maxkueffelbbraun/Space_Battery_SIM/Dok/PCB/BOM/Space_Battery_Test.xlsx

Designator | Name | Description | Quantity | SAP-Partnumber | Manufacturer 1 | Manufacturer Part Number 1 | Supplier Unit Price 1
B1 | ESP32-C6-Zero | ESP32-C6 Mini Development Board, Based on ESP32-C6FH4, Dual Processors, 160MHz Running Frequency, 2.4GHz WiFi 6 & Bluetooth 5, ESP32 Development Board | 1
C1, C2, C3 | 3.9nF | CAP 3.9nF 5% C0G 50V | 3 | 35031280
D1, D2 | 150060VS55040 | Led Green 0603 SMD | 2 | 35146000 | Wurth Elektronik | 150060VS55040 | 0.19
D3, D4 | LED 3mm red | LED Red, 625 nm, GaAsP/GaP, THT, 3mm | 2
D5 | CPDV3V3A-HF | Unidirectional ESD protection diode | 1 | 35140169
D6 (ISP) | BZX84-C20,215 | DIODE ZENER 20V 250MW SOT23 | 1 |  | Nexperia | BZX84-C20,215 | 0.0201
D7 (ISP) | BAV99W,135 | DIODE ARRAY GP 100V 150MA SOT323 | 1 |  | Nexperia | BAV99W,135 | 0.1544
J1, J2 | HDR_M_1X9 |  | 2
J3, J5, J6, J7, J8, J9, J10, J12, J13, J22 | 5-825433-0_2/50 | THT Pin Header, 1x2, 2.54mm, stehend | 10 | 33193339
J4, J11 | Header 1x5 | Header 1x5 2.54mm | 2
Q1 | SI7617DN-T1-GE3 | FET P-CH | 1 | 35140024 | Vishay | SI7617DN-T1-GE3 | 1.78
Q2 | 2N7002LT3G | N-Channel MOSFET 60V 115m, SMD SOT23-3 | 1 | 35140038 | onsemi | 2N7002LT3G | 0.35
Q3, Q4 | IRLMS2002 | FET N-Ch | 2 | 35140704
Q5 (ISP) | BCP51 | BCP51 Trans Gp Bjt PNP 45V 1.5A 1000MW 4-PIN(3+TAB) SOT-223 T/r / Trans PNP 45V 1.5A SOT-223 | 1 |  | onsemi | BCP51 | 0.106
Q6 (ISP) | BCX70G | NPN Silicon AF Transistor, 45 V VCEO, 100 mA IC, SOT23, Reel, Green | 1 |  | Infineon | BCX70GE6327HTSA1 | 0.39
R1, R2, R6 | 2k2 | RES 2K2 1% 125mW 0805 | 3 | 35110490 | Yageo Group | RC0805FR-132K2L | 0.01465
R3 | 36k | RES 2K2 1% 125mW 0805 | 1 | 35110490 | Yageo Group | RC0805FR-132K2L | 0.01465
R4, R7, R9, R12, R13, R14, R15, R16, R17 | 10k | RES 2K2 1% 125mW 0805 | 9 | 35110490 | Yageo Group | RC0805FR-132K2L | 0.01465
R5 | 20k | RES 2K2 1% 125mW 0805 | 1 | 35110490 | Yageo Group | RC0805FR-132K2L | 0.01465
R8 | 100 | RES 2K2 1% 125mW 0805 | 1 | 35110490 | Yageo Group | RC0805FR-132K2L | 0.01465
R10, R11 | 220 | RES 2K2 1% 125mW 0805 | 2 | 35110490 | Yageo Group | RC0805FR-132K2L | 0.01465
R18, R19 | 1k | RES 2K2 1% 125mW 0805 | 2 | 35110490 | Yageo Group | RC0805FR-132K2L | 0.01465
R20, R22, R23 | 5.6E | RES 2K2 1% 125mW 0805 | 3 | 35110490 | Yageo Group | RC0805FR-132K2L | 0.01465
R21 | 47k | RES 2K2 1% 125mW 0805 | 1 | 35110490 | Yageo Group | RC0805FR-132K2L | 0.01465
SW1 | WE_416131160803 | SMD DIP-Switch tripple 1.27mm pitch | 1 |  | Wurth Elektronik | 416131160803 | 3.41
U1 | TSR 1-2450 | DC/DC converter, 5 VDC, 1000 mA, -40 to 85 degC, 3-Pin SIP, RoHS | 1 |  | Traco Power | TSR 1-2450 | 5.91
U2 | NSB1706DMW5T1G | Dual Bias Resistor Transistors, NPN Silicon Surface Mount Transistor, 5-Pin SC70, Pb-Free, Tape and Reel | 1 |  | onsemi | NSB1706DMW5T1G | 0.29
U3 | TS5A23157DGSR | IC SWITCH DUAL SPDT 10MSOP | 1 |  | Texas Instruments | TS5A23157DGSR
U4 | ISO6721BDR | General-purpose, dual-channel, 1/1 digital isolator 8-SOIC -40 to 125 | 1
