maxkueffelbbraun/Space_Battery_SIM/Dok/PCB/Space_Battery_Test V2/Altium/SSOP16_3P98X5_TEX.step

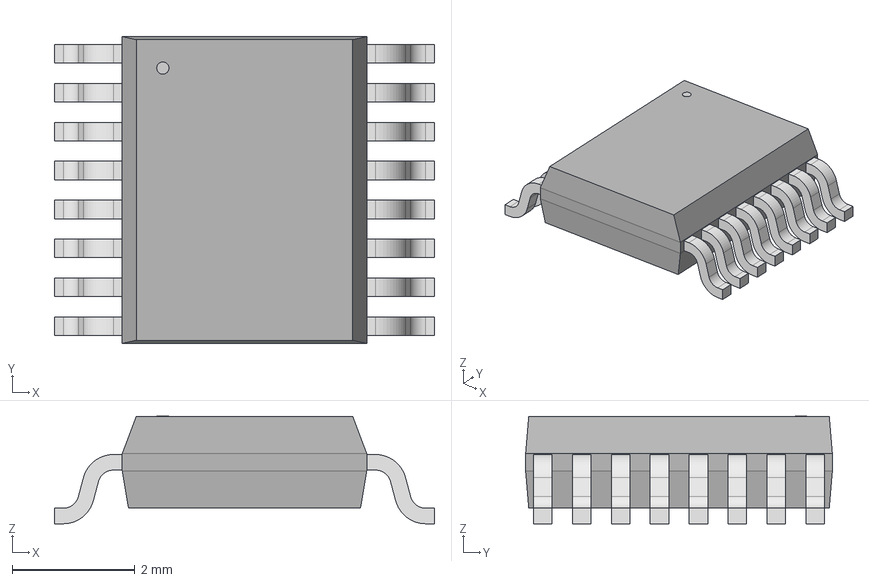
[picture p3: CAD file, 2026-10-27]
Dok/PCB/Space_Battery_Test V2/Altium/SSOP16_3P98X5_TEX.step
6.20 x 5.00 x 1.75 mm
