maxkueffelbbraun/Space_Battery_SIM/Dok/PCB/Space_Battery_Test V2/Altium/ul_ISO6721BDR/Altium/ISO6721BDR/SOIC_1BDR_TEX.step

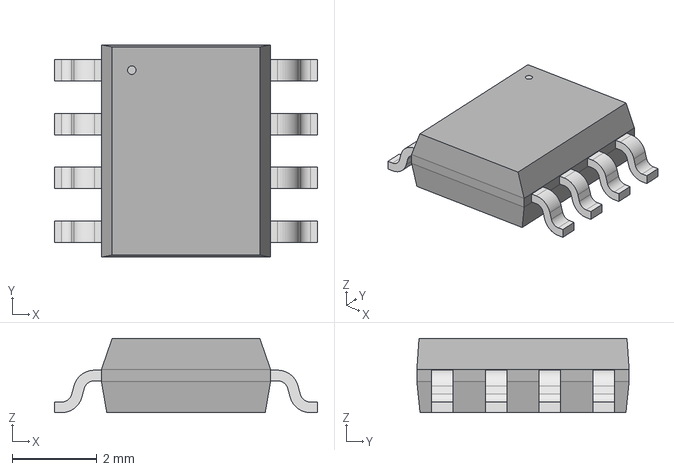
[picture p4: CAD file, 2026-10-27]
Dok/PCB/Space_Battery_Test V2/Altium/ul_ISO6721BDR/Altium/ISO6721BDR/SOIC_1BDR_TEX.step
6.20 x 5.00 x 1.75 mm
