maxkueffelbbraun/Space_Battery_SIM/Dok/PCB/Space_Battery_Test V2/Space_Battery_Test.html

Reporting Options

# File in Newer Format

Date | : | 14.10.2026
Time | : | 22:46:23
Filename | : | C:\Users\kuefmade\OneDrive - B. Braun\Projects\Space\BatteryPack\Simulator\PCB\Space_Battery_Test\Space_Battery_Test.PrjPcb

Version | Warning

Release 23.10

CAUTION - This project contains rules defined using the Constraint Manager. You are seeing this message for two possible reasons. Firstly, this is an older version of the software that does not support this feature, in which case design rules will fall back to being presented as standard, query-based rules. If you save the PCB project in this older version of Altium Designer, all Constraint Manager data structure information will be lost. Secondly, if this software version does support the feature, then you currently don't have the level of Altium Designer Software Subscription (Pro/Enterprise) to be able to edit constraints using the Constraint Manager, in which case it will present rules in view only mode.

This file was generated by a later version of the software
