maxkueffelbbraun/Space_Battery_SIM/Dok/08-Testing Tool/Update tool/Updatetool label.docx

B|BRAUN

Update Tool NiMH Charging Unit

Battery-Pack SP NiMH (8713180A/ 8713180)

Attention: This device shall only be operated

by authorized B.Braun service technicians.

Version.10-2024-V01

B.Braun Melsungen AG

34209 Melsungen, Germany
