maxkueffelbbraun/Space_Battery_SIM/Dok/08-Testing Tool/Update tool/I0027610000 V01 S15 Rev.A - NiMH Akku update tool.pdf

2

3

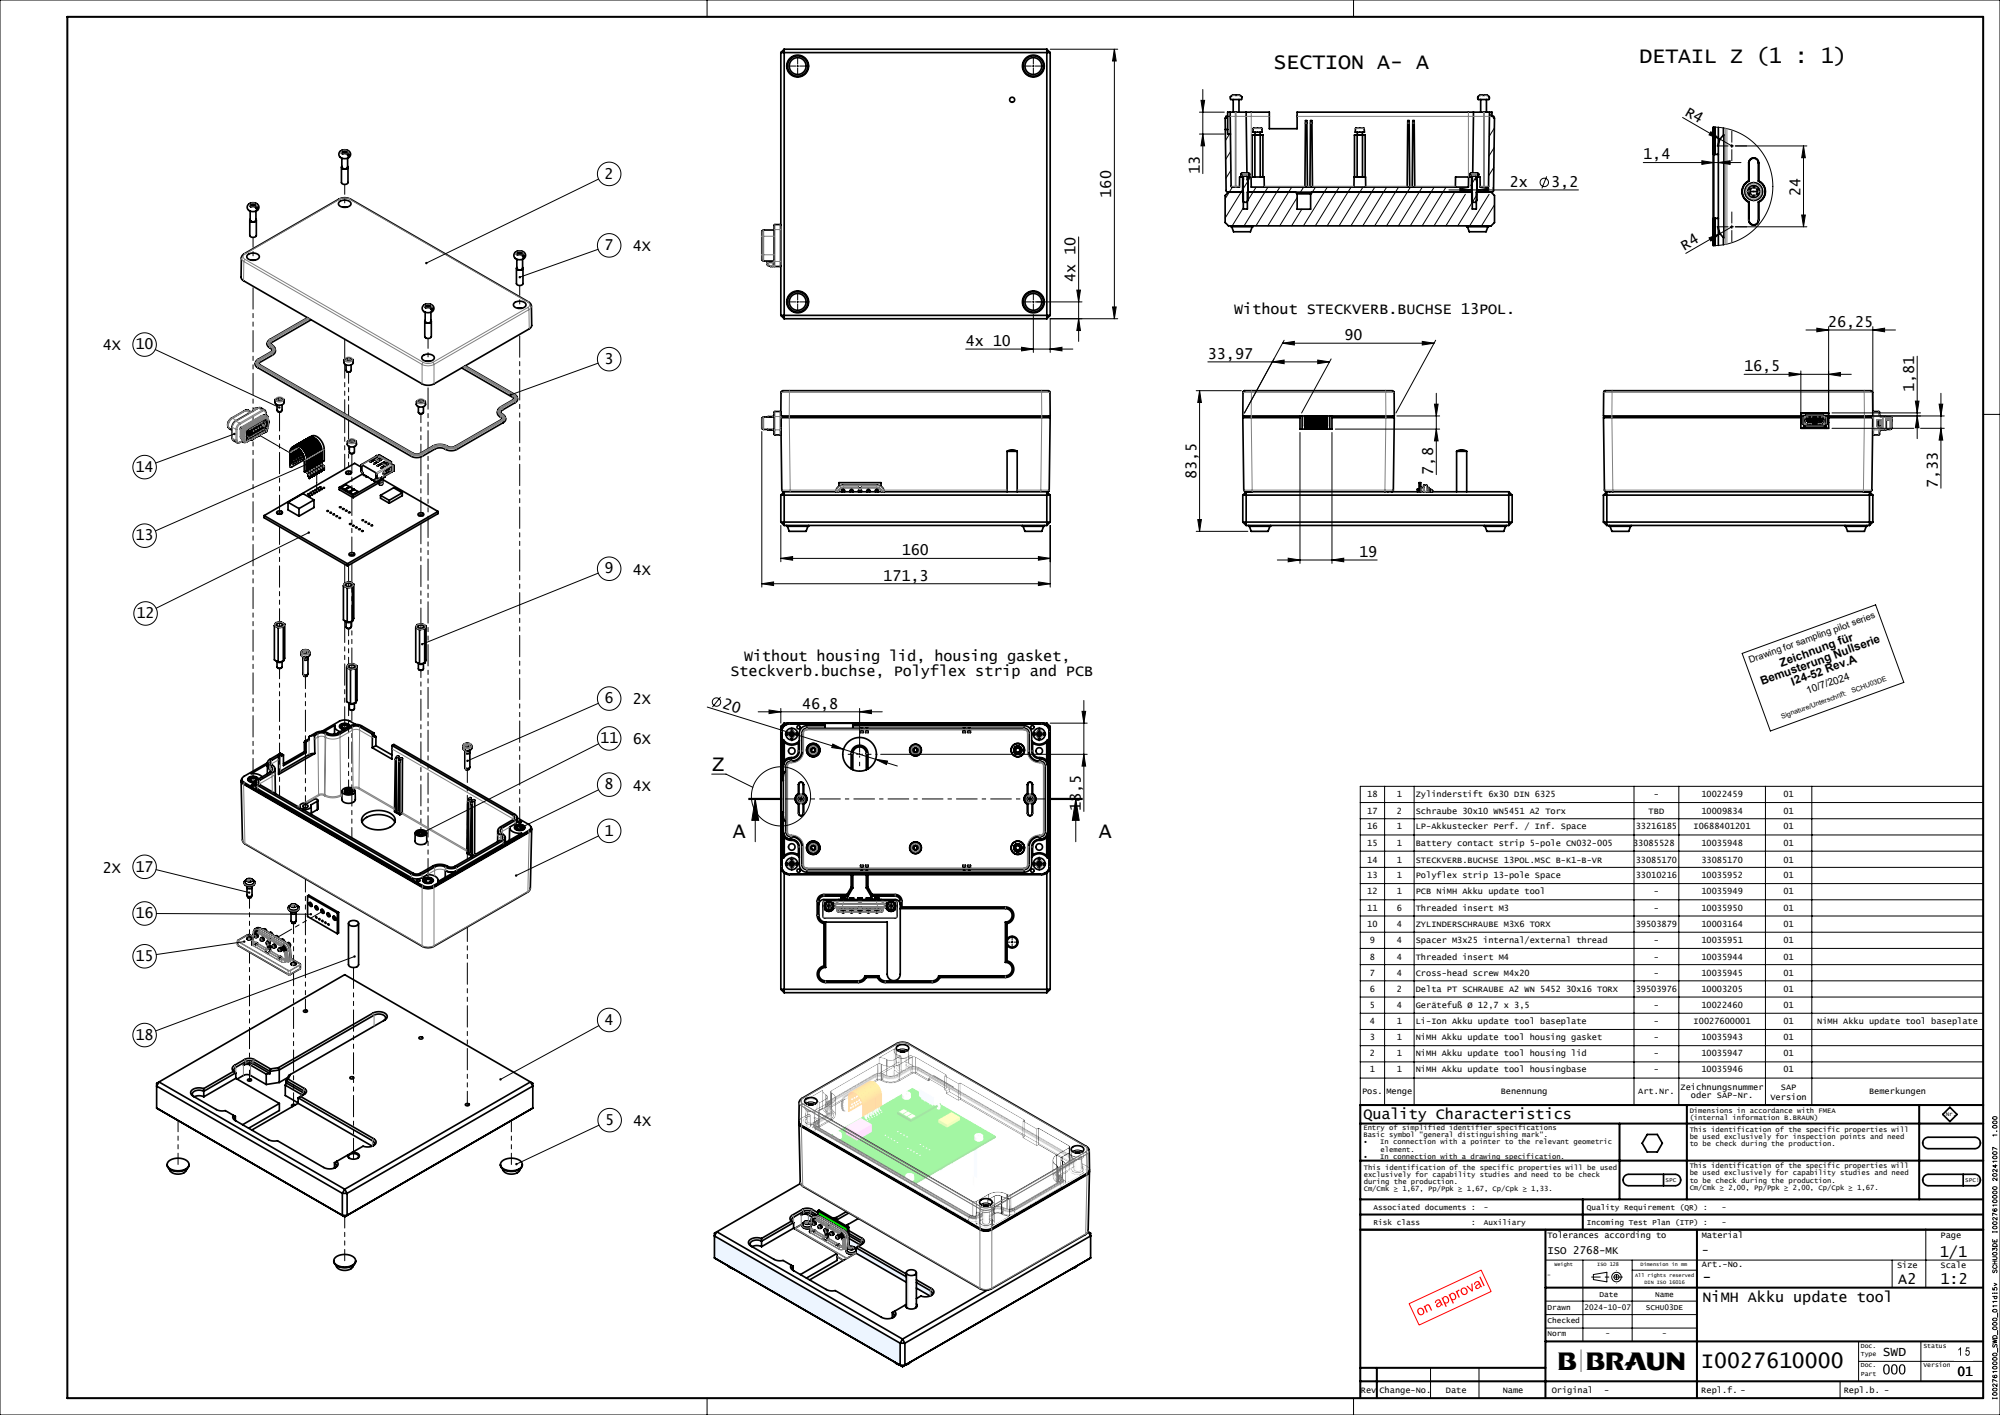
[picture p5: page 1]
10/7/2024 Signature/Unterschrift: SCHU03DE; DETAIL Z (1 : 1); SECTION A- A

Without STECKVERB.BUCHSE 13POL.

Drawing for sampling pilot series

Zeichnung für Bemusterung Nullserie I24-52 Rev.A

Without housing lid, housing gasket,
Steckverb.buchse, Polyflex strip and PCB

18 | 1 | Zylinderstift 6x30 DIN 6325 | - | 10022459 | 01

17 | 2 | Schraube 30x10 WN5451 A2 Torx | TBD | 10009834 | 01
16 | 1 | LP-Akkustecker Perf. / Inf. Space | 33216185 | I0688401201 | 01

15 | 1 | Battery contact strip 5-pole CN032-005 | 33085528 | 10035948 | 01

14 | 1 | STECKVERB.BUCHSE 13POL.MSC B-K1-B-VR | 33085170 | 33085170 | 01
13 | 1 | Polyflex strip 13-pole Space | 33010216 | 10035952 | 01

12 | 1 | PCB NiMH Akku update tool | - | 10035949 | 01

11 | 6 | Threaded insert M3 | - | 10035950 | 01

10 | 4 | ZYLINDERSCHRAUBE M3X6 TORX | 39503879 | 10003164 | 01
9 | 4 | Spacer M3x25 internal/external thread | - | 10035951 | 01

8 | 4 | Threaded insert M4 | - | 10035944 | 01

7 | 4 | Cross-head screw M4x20 | - | 10035945 | 01

6 | 2 | Delta PT SCHRAUBE A2 WN 5452 30x16 TORX | 39503976 | 10003205 | 01

5 | 4 | Gerätefuß Ø 12,7 x 3,5 | - | 10022460 | 01
4 | 1 | Li-Ion Akku update tool baseplate | - | I0027600001 | 01 | NiMH Akku update tool baseplate

3 | 1 | NiMH Akku update tool housing gasket | - | 10035943 | 01

2 | 1 | NiMH Akku update tool housing lid | - | 10035947 | 01

1 | 1 | NiMH Akku update tool housingbase | - | 10035946 | 01

Pos. | Menge | Benennung | Art.Nr. | Zeichnungsnummer oder SAP-Nr. | SAP Version | Bemerkungen

Dimensions in accordance with FMEA Quality Characteristics (internal information B.BRAUN) | Nr.

Entry of simplified identifier specifications Basic symbol "general distinguishing mark". • In connection with a pointer to the relevant geometric element. • In connection with a drawing specification. | | This identification of the specific properties will be used exclusively for inspection points and need to be check during the production.

This identification of the specific properties will be used exclusively for capability studies and need to be check during the production. Cm/Cmk ≥ 1,67, Pp/Ppk ≥ 1,67, Cp/Cpk ≥ 1,33. | SPC | This identification of the specific properties will be used exclusively for capability studies and need to be check during the production. Cm/Cmk ≥ 2,00, Pp/Ppk ≥ 2,00, Cp/Cpk ≥ 1,67. | SPC!

Associated documents : - | Quality Requirement (QR) : -

Risk class : Auxiliary | Incoming Test Plan (ITP) : -

Tolerances according to ISO 2768-MK Weight ISO 128 Dimension in mm | Material Page -1/1 Art.-No. Scale Size - 1:2 A2

All rights reserved
DIN ISO 16016

Date Name Drawn 2024-10-07 SCHU03DE Checked Norm -- | NiMH Akku update tool

B|BRAUN | I0027610000 | Doc. SWD Type 000 Part | Status Version 01 Doc. 01

Rev | Change-No. Date Name | Original - | Repl.f. - -Repl.b.
