maxkueffelbbraun/Space_Battery_SIM/Dok/Schematic.pdf

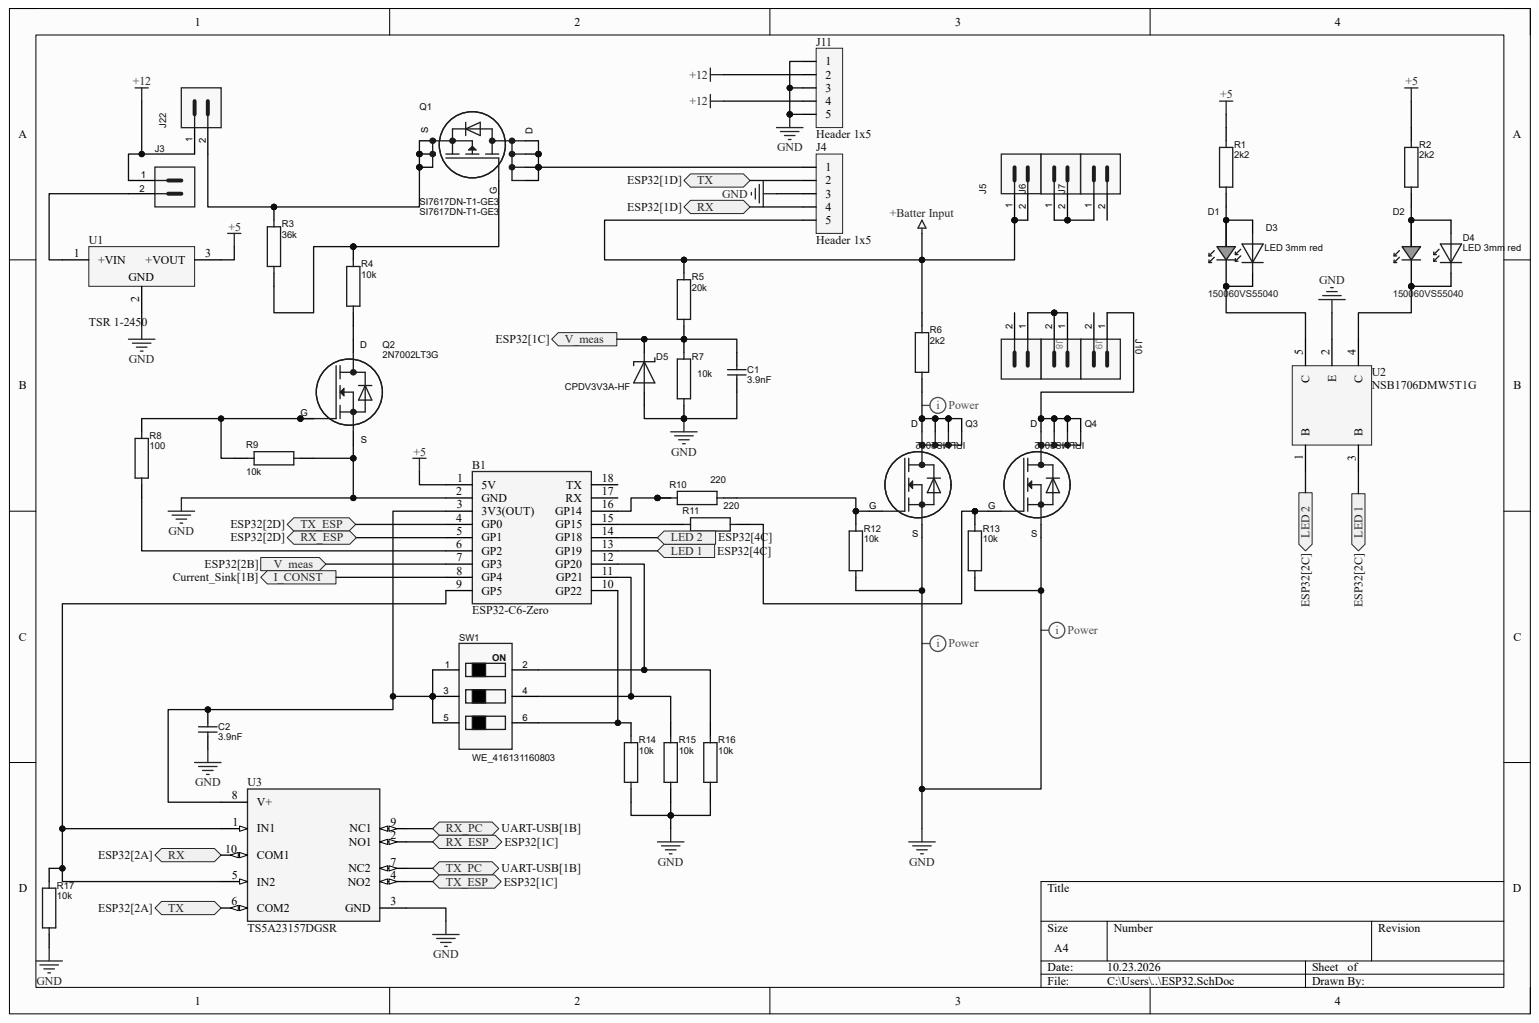
[picture p6: page 1]

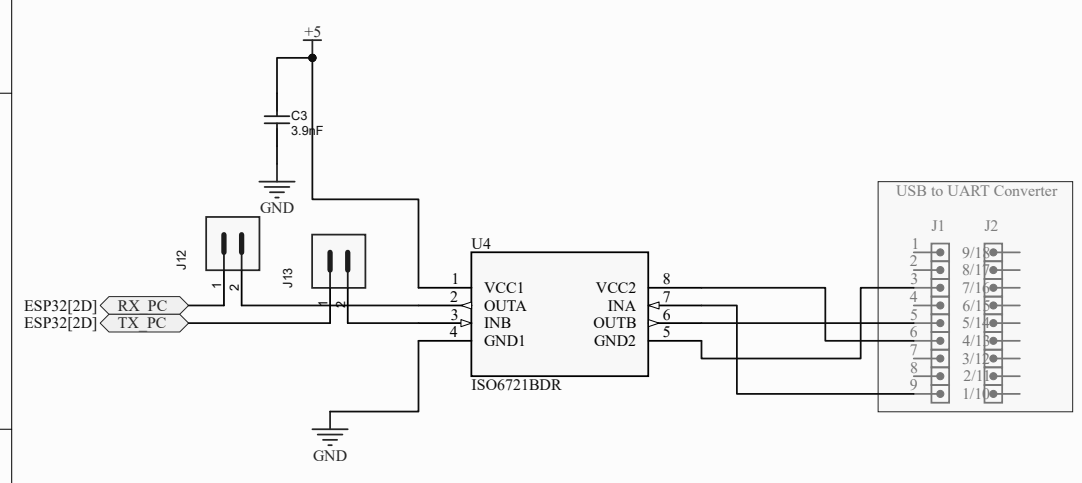
[picture p7: page 2]
Title; Size; Number; Revision; File:; C:\Users\..\UART-USB.SchDoc; Drawn By:; ESP32[2D] RX_PC ESP32[2D] TX_PC; GND; VCC1 1 OUTA 2 INB 3; GND1 4; GND2; OUTB; INA; VCC2; ISO6721BDR ¹

USB to UART Converter

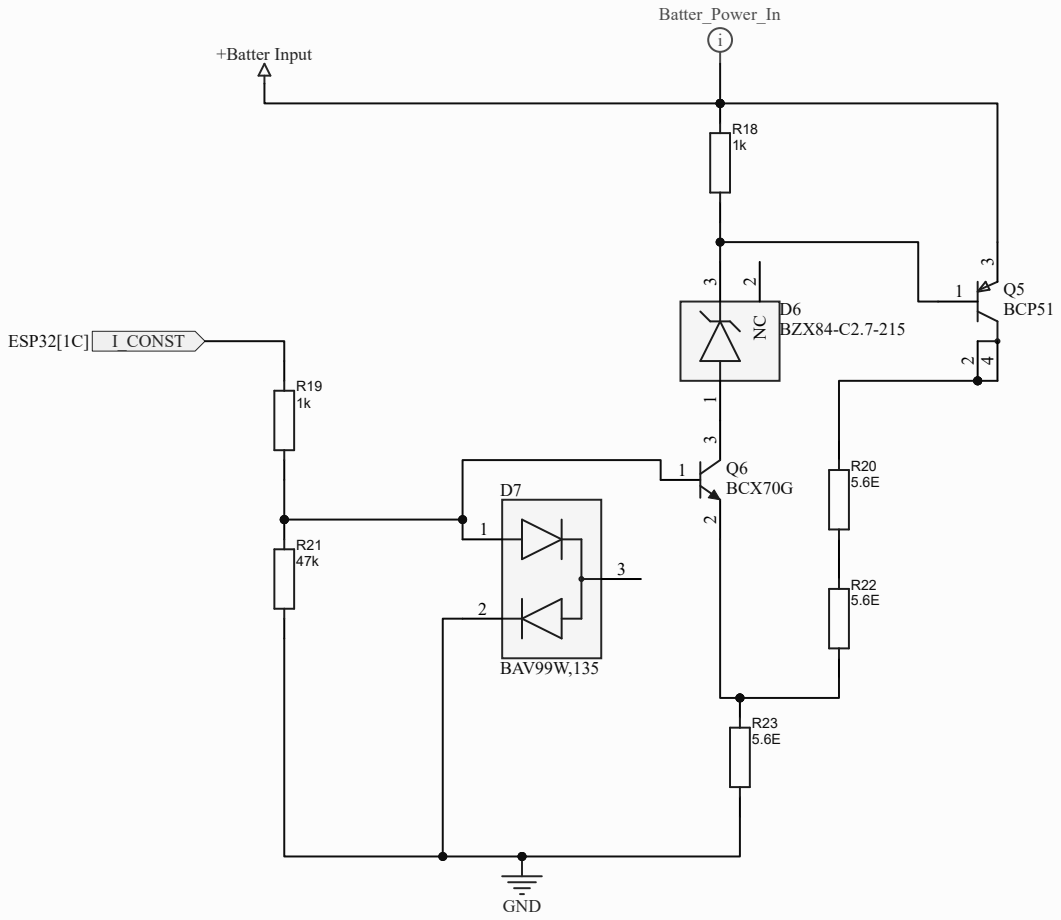
[picture p8: page 3]
