maxkueffelbbraun/Space_Battery_SIM/Dok/PCB/Space_Battery_Test V2/Fertigungsdaten/Zeichnungen/Space - Battery_Test - Bestückzeichnung.PDF

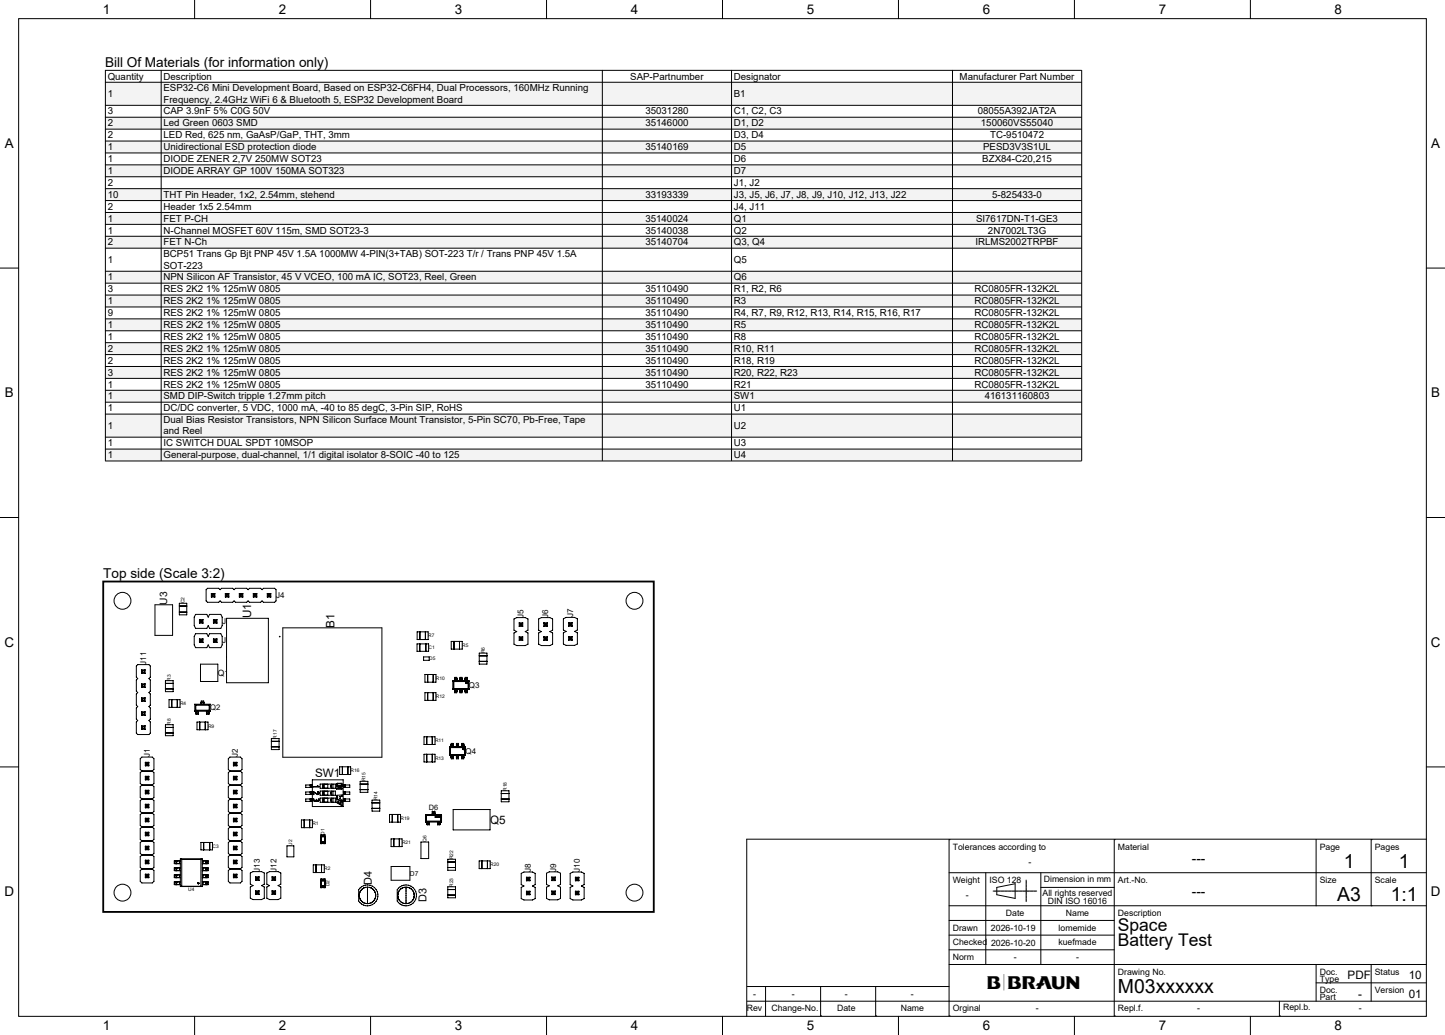
[picture p9: page 1]

Bill Of Materials (for information only)

Quantity | Description | SAP-Partnumber | Designator | Manufacturer Part Number
1 | ESP32-C6 Mini Development Board, Based on ESP32-C6FH4, Dual Processors, 160MHz Running Frequency, 2.4GHz WiFi 6 & Bluetooth 5, ESP32 Development Board | | B1

3 | CAP 3.9nF 5% C0G 50V | 35031280 | C1, C2, C3 | 08055A392JAT2A
2 | Led Green 0603 SMD | 35146000 | D1, D2 | 150060VS55040
2 | LED Red, 625 nm, GaAsP/GaP, THT, 3mm | | D3, D4 | TC-9510472
1 | Unidirectional ESD protection diode | 35140169 | D5 | PESD3V3S1UL
1 | DIODE ZENER 2,7V 250MW SOT23 | | D6 | BZX84-C20,215
1 | DIODE ARRAY GP 100V 150MA SOT323 | | D7
2 | | | J1, J2
10 | THT Pin Header, 1x2, 2.54mm, stehend | 33193339 | J3, J5, J6, J7, J8, J9, J10, J12, J13, J22 | 5-825433-0
2 | Header 1x5 2.54mm | | J4, J11
1 | FET P-CH | 35140024 | Q1 | SI7617DN-T1-GE3
1 | N-Channel MOSFET 60V 115m, SMD SOT23-3 | 35140038 | Q2 | 2N7002LT3G
2 | FET N-Ch | 35140704 | Q3, Q4 | IRLMS2002TRPBF
1 | BCP51 Trans Gp Bjt PNP 45V 1.5A 1000MW 4-PIN(3+TAB) SOT-223 T/r / Trans PNP 45V 1.5A SOT-223 | | Q5

1 | NPN Silicon AF Transistor, 45 V VCEO, 100 mA IC, SOT23, Reel, Green | | Q6
3 | RES 2K2 1% 125mW 0805 | 35110490 | R1, R2, R6 | RC0805FR-132K2L
1 | RES 2K2 1% 125mW 0805 | 35110490 | R3 | RC0805FR-132K2L
9 | RES 2K2 1% 125mW 0805 | 35110490 | R4, R7, R9, R12, R13, R14, R15, R16, R17 | RC0805FR-132K2L
1 | RES 2K2 1% 125mW 0805 | 35110490 | R5 | RC0805FR-132K2L
1 | RES 2K2 1% 125mW 0805 | 35110490 | R8 | RC0805FR-132K2L
2 | RES 2K2 1% 125mW 0805 | 35110490 | R10, R11 | RC0805FR-132K2L
2 | RES 2K2 1% 125mW 0805 | 35110490 | R18, R19 | RC0805FR-132K2L
3 | RES 2K2 1% 125mW 0805 | 35110490 | R20, R22, R23 | RC0805FR-132K2L
1 | RES 2K2 1% 125mW 0805 | 35110490 | R21 | RC0805FR-132K2L
1 | SMD DIP-Switch tripple 1.27mm pitch | | SW1 | 416131160803
1 | DC/DC converter, 5 VDC, 1000 mA, -40 to 85 degC, 3-Pin SIP, RoHS | | U1
1 | Dual Bias Resistor Transistors, NPN Silicon Surface Mount Transistor, 5-Pin SC70, Pb-Free, Tape and Reel | | U2

1 | IC SWITCH DUAL SPDT 10MSOP | | U3
1 | General-purpose, dual-channel, 1/1 digital isolator 8-SOIC -40 to 125 | | U4

Drawn | 2026-10-19 | lomemide
Checked | 2026-10-20 | kuefmade
