maxkueffelbbraun/Space_Battery_SIM/Dok/PCB/Space_Battery_Test V2/Fertigungsdaten/Zeichnungen/Space - Battery_Test - DrillDrawing.PDF

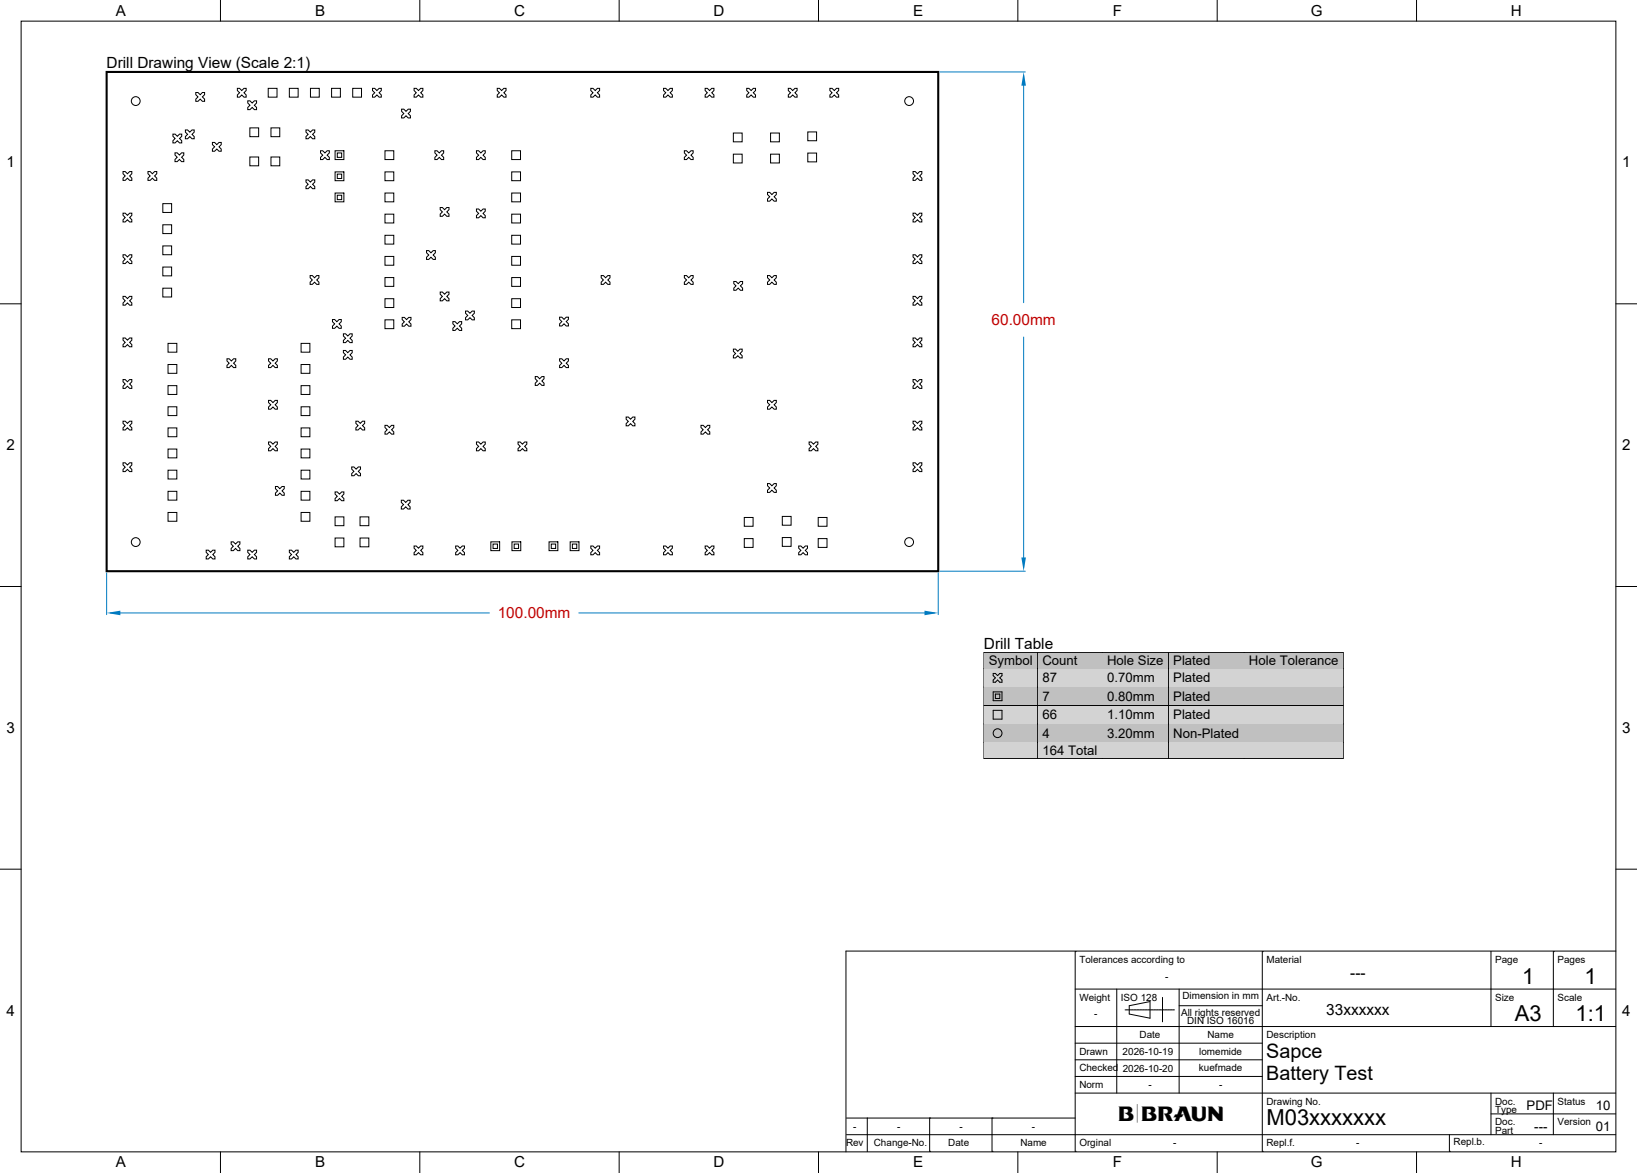
[picture p10: page 1]

Drill Drawing View (Scale 2:1)

Symbol | Count | Hole Size | Plated | Hole Tolerance

87 | 0.70mm | Plated
7 | 0.80mm | Plated
66 | 1.10mm | Plated
4 | 3.20mm | Non-Plated
164 Total

Drawn | 2026-10-19 | lomemide
Checked | 2026-10-20 | kuefmade
