maxkueffelbbraun/Space_Battery_SIM/Dok/PCB/Space_Battery_Test V2/Fertigungsdaten/Zeichnungen/Space - Battery_Test - Schaltplan.PDF

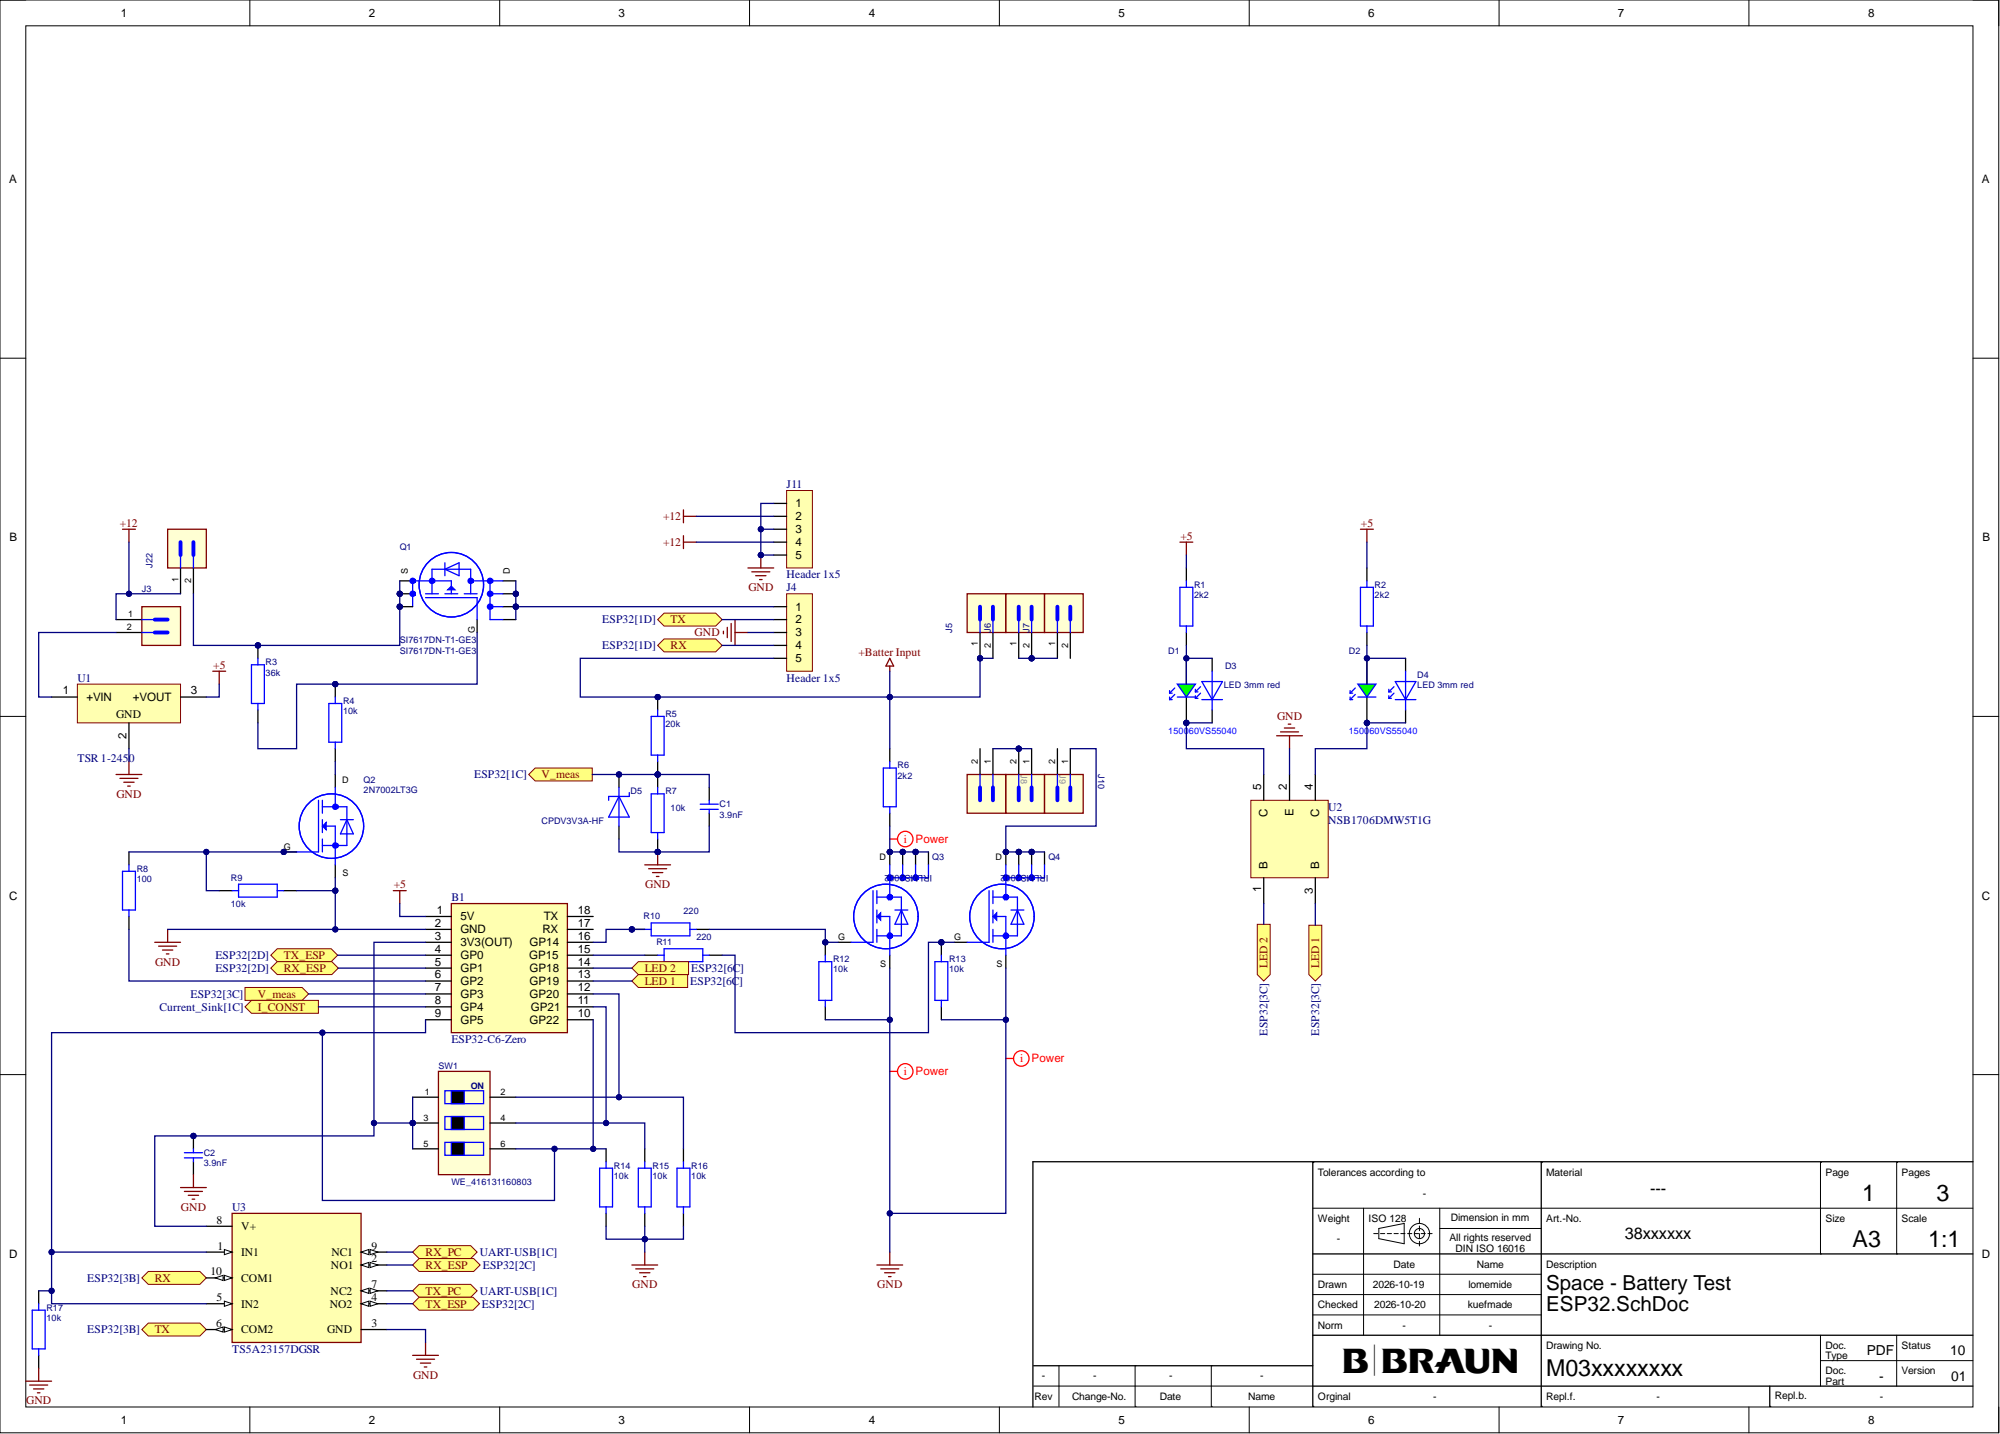
[picture p11: page 1]

3V3(OUT) 3

GP1 5
GP2 6

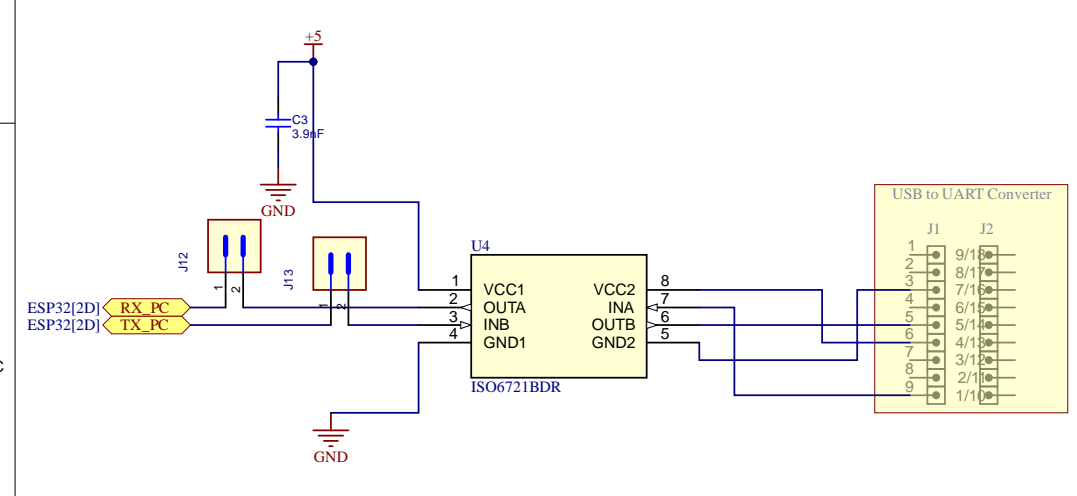
[picture p12: page 2]

2 | 5 OUTB 6 INA 7 VCC2 8 | 123456789

Dra w n | 2 0 2 6-1 0-1 9 | l omemi d e

C h ecke d | 2 0 2 6-1 0-2 0 | ku e fma d e

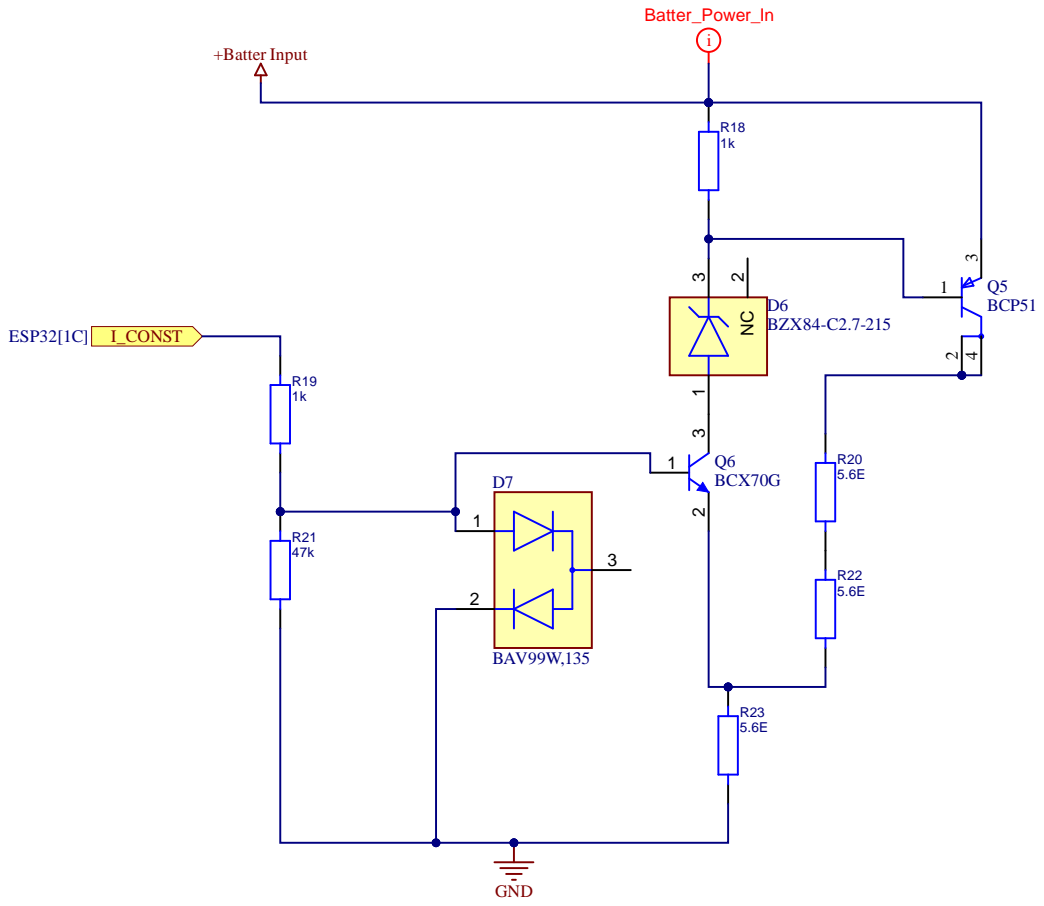
[picture p13: page 3]

Dra w n | 2 0 2 6-1 0-1 9 | l omemi d e

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
