maxkueffelbbraun/Space_Battery_SIM/(list of files, drawings)

Other design files:
Dok/08-Testing Tool/Update tool/Update tool.pcb
Dok/PCB/Space_Battery_Test V2/Altium/ISO6541FQDBQRQ1.PcbLib
Dok/PCB/Space_Battery_Test V2/Altium/ISO6541FQDBQRQ1.SchLib
Dok/PCB/Space_Battery_Test V2/Altium/ul_ISO6721BDR/Altium/ISO6721BDR/ISO6721BDR.PcbLib
Dok/PCB/Space_Battery_Test V2/Altium/ul_ISO6721BDR/Altium/ISO6721BDR/ISO6721BDR.SchLib
Dok/PCB/Space_Battery_Test V2/Current_Sink.SchDoc
Dok/PCB/Space_Battery_Test V2/ESP32.SchDoc
Dok/PCB/Space_Battery_Test V2/Space_Battery_Test.PrjPcb
Dok/PCB/Space_Battery_Test V2/Space_Test_Battery.PcbDoc
Dok/PCB/Space_Battery_Test V2/UART-USB.SchDoc
Dok/PCB/Space_Battery_Test/Altium/ISO6541FQDBQRQ1.PcbLib
Dok/PCB/Space_Battery_Test/Altium/ISO6541FQDBQRQ1.SchLib
Dok/PCB/Space_Battery_Test/Altium/ul_ISO6721BDR/Altium/ISO6721BDR/ISO6721BDR.PcbLib
Dok/PCB/Space_Battery_Test/Altium/ul_ISO6721BDR/Altium/ISO6721BDR/ISO6721BDR.SchLib
Dok/PCB/Space_Battery_Test/Current_Sink.SchDoc
Dok/PCB/Space_Battery_Test/ESP32.SchDoc
Dok/PCB/Space_Battery_Test/Space_Battery_Test.PrjPcb
Dok/PCB/Space_Battery_Test/Space_Test_Battery.PcbDoc
Dok/PCB/Space_Battery_Test/UART-USB.SchDoc
