maxkueffelbbraun/Space_Battery_SIM/(commit log)

2026-10-23 Initial ESP32-C6 battery UART test firmware (PlatformIO/ESP-IDF)
    [Update tool.pcb, Update_Tool.sch]
2026-10-23 Add B.Braun 5-byte frame protocol (probe/info/rd/wr), ignore logs
2026-10-23 Onboard WS2812 status LED with background link poll; DIP pulldowns
2026-10-27 Align UART timing with reference script, enable RX pull-up, add README
2026-10-27 Fix swapped red/green on onboard RGB LED (use RGB component order)
    [main.c]
2026-10-27 Add Altium PCB project data (V1, V2), manufacturing data and BOM; ignore Altium backups
    [Current_Sink.SchDoc, ESP32.SchDoc, ISO6541FQDBQRQ1.PcbLib, ISO6541FQDBQRQ1.SchLib, ISO6721BDR.PcbLib, ISO6721BDR.SchLib, SOIC_1BDR_TEX.step, SSOP16_3P98X5_TEX.step]
